pramodj196/Audio-Recorder/(list of files, drawings)

Other design files:
1.0 FINAL EVALUATION/Arduino/Simulation/Proteus Simulation/combined_2_0832.pdsprj
1.0 FINAL EVALUATION/AVR/LCD_i2c/Simulation/test.pdsprj
1.0 FINAL EVALUATION/AVR/SD with LCD/simulation/sd_lcd_atmega328.pdsprj
ADC in AVR/ADC_328P.pdsprj
All_combined(R2R_withoutAmplifier)/all_combined_R2R(withoutAmplifier).pdsprj
all_combined_dac0832_simul/combined_2_0832.pdsprj
blinking 2 LED/blinking2LED.pdsprj
comb_vir_mic/microphone.pdsprj
dac0832 with mic/dac0-0832 simulation/DAC.pdsprj
DAC/DAC.pdsprj
Finalized Recorder/Combined/LCD with I2C connector.pdsprj
i2c_lcd_atmega328p/simulation/lcd+i2c_atmega328p.pdsprj
LCD with I2C connector/LCD with I2C connector.pdsprj
LCD_simulation 3rd week/LCD Display.pdsprj
LCD_simulation/LCD Display.pdsprj
Mic_with_LCD/ADC/PCM.pdsprj
Mic_with_LCD/Microphone/microphone 1.pdsprj
Mic_with_LCD/Microphone/microphone_with_LCD.pdsprj
Microphone/microphone.pdsprj
R 2R DAC/r-2r dac.pdsprj
Read _Write_SD/Proteus files/Input circuit/ADC input with music notes.pdsprj
Read _Write_SD/Proteus files/Input circuit/updated mic and record.pdsprj
Read _Write_SD/Proteus files/Output circuit/devindis_speaker.pdsprj
SAMPLES/Microphone demo/model.DSN
SdAtmega328/Simulation/sd_lcd_atmega328.pdsprj
Simulation Schematic Capture2/audio recorder2.pdsprj
Simulation Schematic Capture/Audio Recorder.pdsprj
speaker/speaker.pdsprj
