pramodj196/Audio-Recorder/1.0 FINAL EVALUATION/AVR/LCD_i2c/Code/LCD_i2c/i2c.h

/*
 * i2c.h
 *
 * Created: 8/10/2021 1:58:26 PM
 *  Author: Bavi
 */ 


#ifndef I2C_H_
#define I2C_H_

#include <avr/io.h>

#define  F_CPU 16000000UL

void i2c_init(){
	TWBR = 0x62;		//	Baud rate is set by calculating
	TWCR = (1<<TWEN);	//Enable I2C
	TWSR = 0x00;		//Prescaler set to 1

}
//Start condition
void i2c_start(){
	TWCR = (1<<TWINT) | (1<<TWEN) | (1<<TWSTA);	//start condition
	while (!(TWCR & (1<<TWINT)));				//check for start condition

}
//I2C stop condition
void i2c_write(char x){				//Cpn esta funcion se escribe en el bus de TWDR
	TWDR = x;						//Move value to I2C
	TWCR = (1<<TWINT) | (1<<TWEN);	//Enable I2C and clear interrupt
	while  (!(TWCR &(1<<TWINT)));
}

char i2c_read(){
	TWCR  = (1<<TWEN) | (1<<TWINT);	//Enable I2C and clear interrupt
	while (!(TWCR & (1<<TWINT)));	//Read successful with all data received in TWDR
	return TWDR;
}




#endif /* I2C_H_ */
