pramodj196/Audio-Recorder/(commit log)

2021-03-26 arduino testing
2021-03-31 testing Proteus simulation for 2 LEDs using arduino
    [blinking2LED.pdsprj]
2021-04-01 simulation schematic capture1
    [Audio Recorder.pdsprj]
2021-04-02 schematic capture uodae
    [Audio Recorder.pdsprj]
2021-04-02 schematic capture update layout
    [Audio Recorder.pdsprj]
2021-04-03 Simulation Schematic Capture2
    [Audio Recorder.pdsprj, audio recorder2.pdsprj]
2021-04-04 simulation schematic capture 02 mod
    [Audio Recorder.pdsprj, audio recorder2.pdsprj]
2021-04-04 Schematic capture 2 mod_01
    [audio recorder2.pdsprj]
2021-04-04 schematic capture 2 mod_02
    [audio recorder2.pdsprj]
2021-04-04 adding models
    [audio recorder2.pdsprj, model.DSN]
2021-04-05 shifting the pitch of audio signal
2021-04-05 Record audio and saving
    Recording audio and saving it as sample1.wav file
2021-04-06 changing capacitors to polarized caps
    [audio recorder2.pdsprj]
2021-04-06 Updating the x axis limits of the graphs
2021-04-19 LCD_simulation
    Tried to display a few on LCD Display
    [LCD Display.pdsprj]
2021-04-27 combining virtual terminal and microphone module
    [microphone.pdsprj]
2021-04-27 speaker circuit
    [speaker.pdsprj]
2021-04-27 Adding a DC offset and changing capacitor, resistor values
    [microphone 1.pdsprj]
2021-04-30 SD read and write
    [ADC input with music notes.pdsprj, devindis_speaker.pdsprj, updated mic and record.pdsprj]
2021-05-01 LCD simulation progress 3
    Changed the connected pins from analog pins to digital pins
    [LCD Display.pdsprj]
2021-05-02 Combined Mic with LCD
    Combined the Mic and LCD simulation together
    [PCM.pdsprj, microphone 1.pdsprj, microphone_with_LCD.pdsprj]
2021-05-02 Updating the Microphone
    [microphone_with_LCD.pdsprj]
2021-05-04 R-2R DAC
    [r-2r dac.pdsprj]
2021-05-05 Simulate DAC of musical notes
    [r-2r dac.pdsprj]
2021-05-06 LCD with I2C connector
    Used I2C connector to connect LCD with arduino to reduce the pins used
    [LCD with I2C connector.pdsprj]
2021-05-09 DAC0832 IC with microphone and speaker circuit
    [DAC.pdsprj]
2021-05-10 connecting SD card with arduino board
    [r-2r dac.pdsprj]
2021-05-11 combined circuit
    [LCD with I2C connector.pdsprj]
2021-05-23 AVR coding for lcd_i2c
    [lcd+i2c_atmega328p.pdsprj]
2021-05-25 avr code for i2c_lcd
2021-05-26 proteus simulation of lcd with atmega 328p
    [lcd+i2c_atmega328p.pdsprj]
2021-05-26 correcting errors of lcd avr
    [lcd+i2c_atmega328p.pdsprj]
2021-05-27 adding a filter circuit to the output of DAC0832
    [DAC.pdsprj]
2021-05-27 addind DAC0832 Ic to proteus simulation
    [combined_2_0832.pdsprj]
2021-05-27 Final Circuit
    [LCD with I2C connector.pdsprj]
2021-05-28 correctimg the error of clipping
    [combined_2_0832.pdsprj]
2021-05-28 Added amplifier circuit to the speaker
    [LCD with I2C connector.pdsprj]
2021-05-28 Added microphone circuit to the input
    [combined_2_0832.pdsprj]
2021-05-28 Added speaker circuit without the amplifier
    [all_combined_R2R(withoutAmplifier).pdsprj]
2021-05-29 SAMPLE
    REally don't know what this is
2021-06-09 correcting the clock frequency to 16MHz
    [lcd+i2c_atmega328p.pdsprj]
2021-06-12 ADC in AVR
    [ADC_328P.pdsprj]
2021-06-16 Combined code in avr using SD.h and SPI.h arduino libraries
2021-06-16 Circuit for simulation in proteus
    [sd_lcd_atmega328.pdsprj]
2021-06-16 Adding an internal interrupt to write to file
    [sd_lcd_atmega328.pdsprj]
2021-06-17 Reducing the delay after "File saved " is printed
2021-06-17 Shifting the starting point of the messages printed in the lcd screen
2021-08-09 testing arduino code writing files
2021-08-09 tested code for arduino
2021-08-11 Uploading Files for Final demonstration
    [combined_2_0832.pdsprj, sd_lcd_atmega328.pdsprj, test.pdsprj]
